PV-Lab/hte_degradation_chamber_gen2/MIT Gen2 Chamber BOM.xlsx

Material | Chamber Use Description | Cost | Link | ALL PRICES BASED ON US$ IN 2022
Clear polished acrylic 5-sided box 30x20x20cm | Outer chamber | $54.27 | https://www.shoppopdisplays.com/10096/acrylic-5-sided-box-8h-x-8w-x-12l.html
Clear polished acrylic 5-sided box 16x16x16cm | Inner chamber | $25.19 | https://www.shoppopdisplays.com/10091/acrylic-5-sided-box-6-x-6-x-6.html
Clear acrylic sheet 15/64" Thick | Inner chamber base plate | $8.41 | https://www.mcmaster.com/8560K179/
White Delrin sheet 1" Thick, 6"x6" | Buoyancy railing; support feet | $35.23 | https://www.mcmaster.com/8573K126/
Aluminum sheet 0.08" Thick | Camera frame | $11.29 | https://www.mcmaster.com/89015K191/
ThorLabs DCC1645C, Obsolete: replaced by ThorLabs CS165CU | Camera imager | $448.05 | https://www.thorlabs.com/thorproduct.cfm?partnumber=CS165CU
ThorLabs MVL6WA | Camera lens | $166.38 | https://www.thorlabs.com/thorproduct.cfm?partnumber=MVL6WA
PVC film 0.12" Thick | Clear chamber cover | $20.38 | https://www.mcmaster.com/87875K63/
Quartz disk 1" Diam, 1/4" Thick | Camera anti-refraction lens | $21.43 | https://www.mcmaster.com/1357T31/
Xrite ColorChecker Passport, Discontinued; replaced by SCK200 SpyderCHCKR 24 | Camera color calibration | $49.00 | https://www.amazon.com/dp/B00LPS46TW?s=photo&sp_csd=d2lkZ2V0TmFtZT1zcF9kZXRhaWxfdGhlbWF0aWM
Silicone tube 1/2" ID x 5/8" OD | Temperature control water tube | $15.99 | https://www.amazon.com/Feelers-Silicone-Silicon-Brewing-Winemaking/dp/B093F5P8K7
Tube push fitting pneumatic male straight | Connecting water tubes to heating tube | $10.36 | https://www.amazon.com/mxuteuk-Connect-Fittings-Pneumatic-Straight/dp/B07ZJ578ZW
25 Watt resistance heater | Water heater | $27.17 | https://www.mcmaster.com/3641K21/
