PV-Lab/hte_degradation_chamber_gen2/Humidity_control_via_valve_v20220606.ino

// 

/*

    Humidity control via a magnetic valve

    Control air humidity in an aging chamber by turning on/off a magnetic valve (type: normally open) that
    is used for feeding in dry gas (nitrogen or dry air) from a gas line. Arduino controls the valve
    (connected to pin 4). An LED (connected to pin 13) is on when the system is running. Si7021 measures
    the air humidity level. It is recommendable to enable serial monitor printouts to ensure that the
    system runs properly.

    The circuit:
    
    * See the build guide ( https://github.com/PV-Lab/hte_degradation_chamber ) for the circuit.

    Inputs:
    
    * SDA: I2C data pin for Si7021 sensor.
    
    
    Outputs:
    
    * GND: 24V power for the valve (-) via a transistor-resistor circuit.
    * Digital pin 4: Control valve (open/closed) via a transistor-resistor circuit.
    
    * Digital pin 13: LED (+)
    * GND: LED (-)
    
    * SCL: I2C clock pin for Si7021 sensor.
    * 3V3: 3V power for Si7021 sensor.
    * GND: Ground for Si7021 sensor.
    
    Created 2019

    By Alex Encinas

    Modified 06/06/2022

    By Armi Tiihonen


    http://url/of/online/tutorial.cc


*/
//   =====================================================================================================
//   ================================          USER INPUT        =========================================
//   =====================================================================================================

float Desired_Humidity = 87; // Target air humidity in percentage value.
// Note: The humidity control setup operates via decreasing air humidity from 100% air humidity that is
// the base state in the enclosed degradation chamber with water and a constantly rotating fan inside. Air
// humidity is decreased by feeding in dry gas through the valve.
// Note: Nitrogen or air can be used in the dry gas line. Feeding in nitrogen will affect the oxygen
// level within the chamber if low humidity levels are targeted, which should be noted when testing samples
// sensitive to oxygen in air. 
// Note: When altering the value, press Upload and wait until Arduino IDE reports "Done uploading" at the
// bottom of the screen (turquoise line). There should be only white text in the box with black background.
// If there is text with orange/red color, press Verify and Upload again. After you get "Done
// uploading", Press Tools - Serial monitor to get the print outs visible. Arduino should start printing
// out values in a couple of seconds.

float Tolerance = 0.0; // Close the valve at Desired_Humidity-Tolerance. Default value is 0%.

//   =====================================================================================================
//   ========================       SENSOR LIBRARY AND DECLARATION           =============================
//   =====================================================================================================

// Libraries required. These libraries which requires  to be installed
// To install "Adafruit Si7021 Library", go to Sketch -> Include Library -> Manage Libraries. Look up
// "Adafruit Si7021 Library" and click install.
#include "Adafruit_Si7021.h"
Adafruit_Si7021 sensor = Adafruit_Si7021(); //Declare the sensor and call it 'sensor'


//   =====================================================================================================
//   ==================      VARIABLE DECLARATION/ASSIGNMENT/CALCULATION         =========================
//   =====================================================================================================

#define DEBUG
 
#define valvePin 4  // The pin to which the valve is connected in Arduino. Default value: 4
#define LEDPin 13 // The pin to which the LED indicating the humidity control system runs is connected to.
// Default value: 13
float initial_wait_time = 30000; // Time (in milliseconds) from plugging Arduino in to the first time valve turns on.
float h; // Humidity reading (%)
float error_h; // The deviation of the current humidity value from the target humidity.
float pre_h = 0; // Humidity reading at the beginning of the loop.
float diff_h = 0; // The difference in the humidity reading between the beginning and end of the loop.
float loop_time = 5000; // Time (in milliseconds) before the system responds again

// PrintWriter output;



//   =====================================================================================================
//   ============================       SET-UP (ONE TIME CODE)         ===================================
//   =====================================================================================================
void setup() {
  
  Serial.begin(9600);
  while (!Serial) {   // Wait for serial port to open.
    delay(10);
  }
  sensor.begin(); // Initialize sensor Si7021.
  pinMode(ValvePin,OUTPUT); // Initialize the pin where the solenoid is connected
  // (declared top of the file).
  pinMode(LEDPin,OUTPUT); // Initialize the pin where the indicator LED is connected (declared top of the file).

  #ifdef DEBUG
    Serial.print("Targeted Relative Humidity: ");
    Serial.print(Desired_Humidity);
    Serial.println("%");
    Serial.print("Tolerance: +-");
    Serial.print(Tolerance);
    Serial.println("%");  
    Serial.print("Initializing... getting accurate initial reading for sensor (delay = ");
    Serial.print(float(initial_wait_time/60000));
    Serial.println(" minutes)");
  #endif
  pre_h = sensor.readHumidity();
  delay(initial_wait_time); // Initial wait time for the system to start
  
}


void loop() {
//   =====================================================================================================
//   =============================    CALCULATE CONTROL VARIABLES      ===================================
//   =====================================================================================================
  
  h = sensor.readHumidity();
  error_h = Desired_Humidity - h;
  diff_h = (h - pre_h);

  #ifdef DEBUG
    Serial.println(" ");
    Serial.print("Current RH:  ");
    Serial.print(h);
    Serial.print("%     ");
    Serial.print("Deviation in RH from the target level:  ");
    Serial.print(error_h);
    Serial.print("%     ");    
    Serial.print("Change in RH during the previous step:  ");
    Serial.print(diff_h);
    Serial.println("%");
  #endif
 
  delay(1000);  // Short delay to make sure we don't take readings too fast (could mess up the sensor).

//   =====================================================================================================
//   =========================    DECISION MAKING (TURN ON OR WAIT)      =================================
//   =====================================================================================================

  if (h < (Desired_Humidity-Tolerance)) {
    digitalWrite(ValvePin,HIGH); // Close the valve.
  }
  else {
    digitalWrite(ValvePin,LOW); // Open the valve.
  }
  
    
    delay(loop_time); // Wait for the pre-set duration before going back to make another decision step.

  pre_h = h;



}
