PV-Lab/hte_degradation_chamber_gen2/(commit log)

2022-08-15 Add files via upload
    Bill of materials added
    [MIT Gen2 Chamber BOM.xlsx]
2022-08-17 Delete MIT Gen 2 Chamber Build Guide.pdf
    Remove old version of the guide.
